miguelitoVargas/seqExplora/modulo_botones/pcb_mod_btn.kicad_pcb

## KiCad design modulo_botones/pcb_mod_btn.kicad_pcb (2018-06-20)

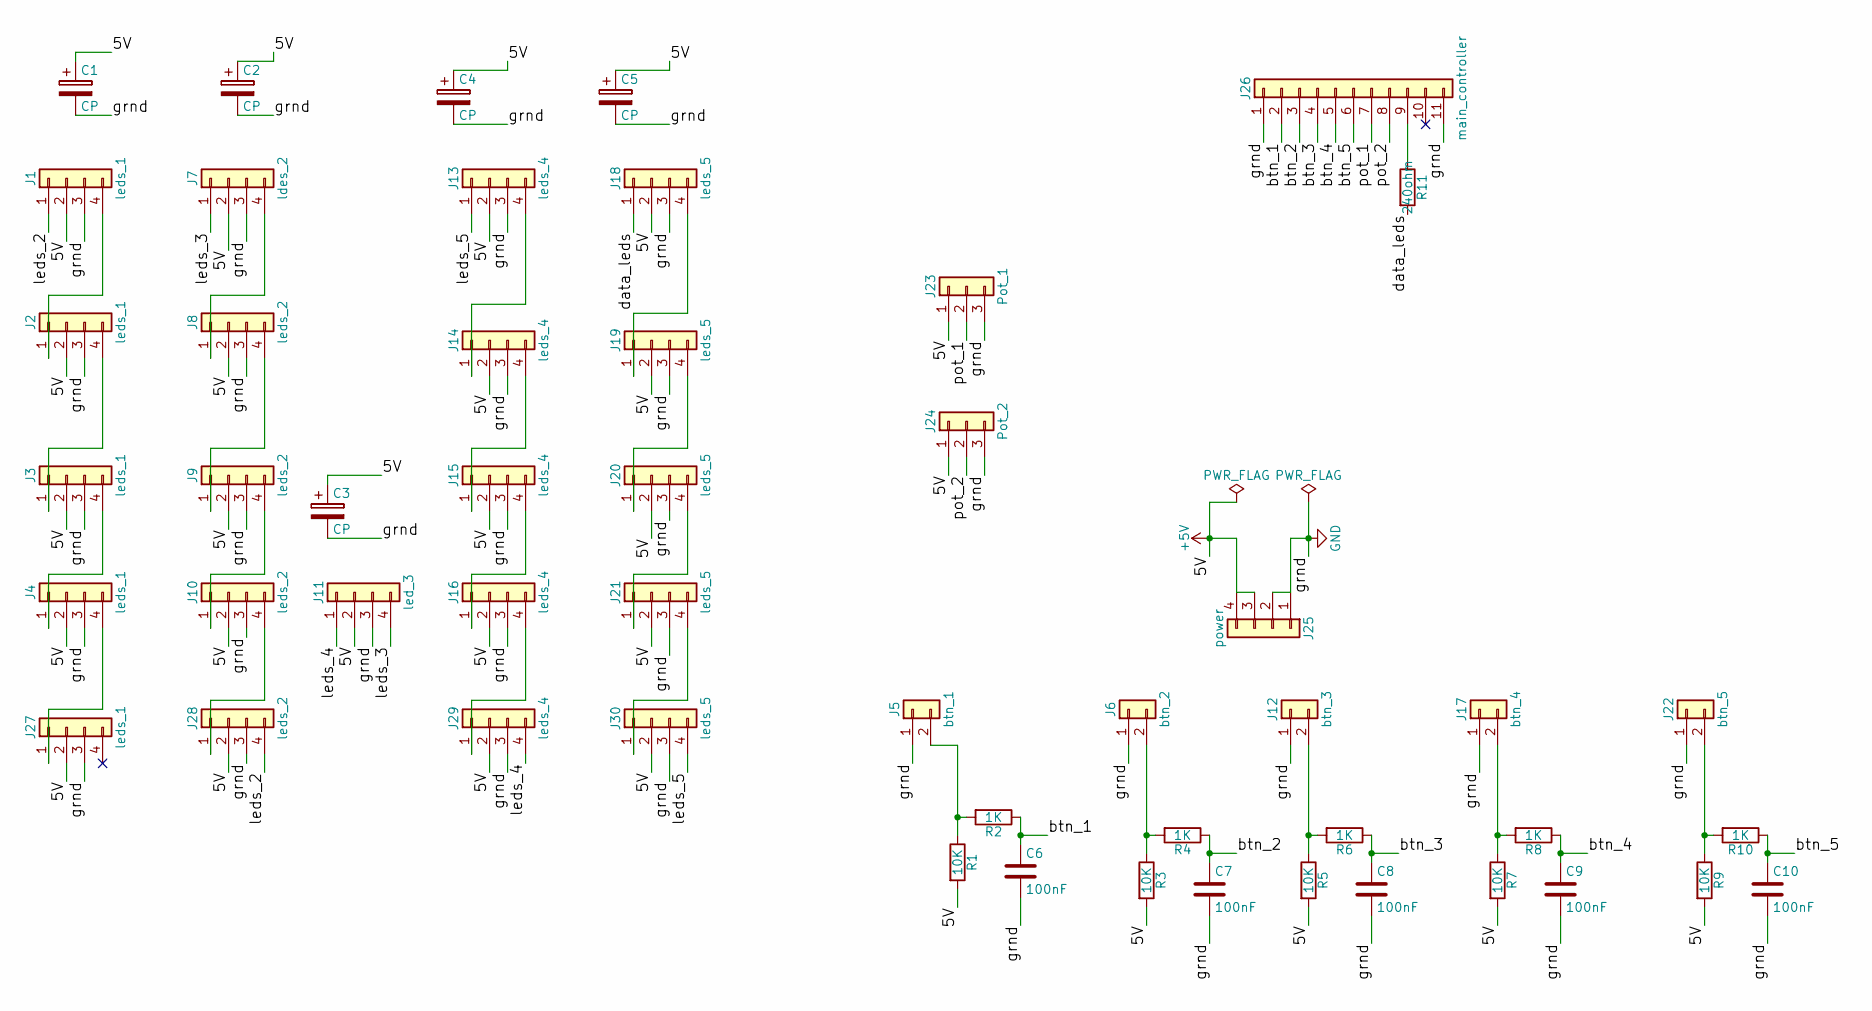
[picture p1: schematic pcb_mod_btn.sch]

Parts:
C1, C2, C3, C4, C5: CP; CP_Radial_D8.0mm_P5.00mm
C6, C7, C8, C9, C10: 100nF; C_0805_HandSoldering
J1, J2, J3, J4, J27: leds_1; Pin_Header_Straight_1x04_Pitch2.54mm
J5: btn_1; Pin_Header_Straight_1x02_Pitch2.54mm
J6: btn_2; Pin_Header_Straight_1x02_Pitch2.54mm
J7: ldes_2; Pin_Header_Straight_1x04_Pitch2.54mm
J8, J9, J10, J28: leds_2; Pin_Header_Straight_1x04_Pitch2.54mm
J11: led_3; Pin_Header_Straight_1x04_Pitch2.54mm
J12: btn_3; Pin_Header_Straight_1x02_Pitch2.54mm
J13, J14, J15, J16, J29: leds_4; Pin_Header_Straight_1x04_Pitch2.54mm
J17: btn_4; Pin_Header_Straight_1x02_Pitch2.54mm
J18, J19, J20, J21, J30: leds_5; Pin_Header_Straight_1x04_Pitch2.54mm
J22: btn_5; Pin_Header_Straight_1x02_Pitch2.54mm
J23: Pot_1; Pin_Header_Straight_1x03_Pitch2.54mm
J24: Pot_2; Pin_Header_Straight_1x03_Pitch2.54mm
J25: power; TerminalBlock_bornier-4_P5.08mm
J26: main_controller; Pin_Header_Straight_1x11_Pitch2.54mm
R1, R3, R5, R7, R9: 10K; R_0805_HandSoldering
R2, R4, R6, R8, R10: 1K; R_0805_HandSoldering
R11: 240ohm; R_0805_HandSoldering

Connections:
+5V: C1.1, C2.1, C3.1, C4.1, C5.1, J1.2, J2.2, J3.2, J4.2, J7.2, J8.2, J9.2, J10.2, J11.2, J13.2, J14.2, J15.2, J16.2, J18.2, J19.2, J20.2, J21.2, J23.1, J24.1, J25.3, J25.4, J27.2, J28.2, J29.2, J30.2, R1.2, R3.2, R5.2, R7.2, R9.2
/btn_1: C6.1, J26.2, R2.1
/btn_2: C7.1, J26.3, R4.1
/btn_3: C8.1, J26.4, R6.1
/btn_4: C9.1, J26.5, R8.1
/btn_5: C10.1, J26.6, R10.1
/data_leds: J18.1, R11.2
/leds_2: J1.1, J28.4
/leds_3: J7.1, J11.4
/leds_4: J11.1, J29.4
/leds_5: J13.1, J30.4
/pot_1: J23.2, J26.7
/pot_2: J24.2, J26.8
GND: C1.2, C2.2, C3.2, C4.2, C5.2, C6.2, C7.2, C8.2, C9.2, C10.2, J1.3, J2.3, J3.3, J4.3, J5.1, J6.1, J7.3, J8.3, J9.3, J10.3, J11.3, J12.1, J13.3, J14.3, J15.3, J16.3, J17.1, J18.3, J19.3, J20.3, J21.3, J22.1, J23.3, J24.3, J25.1, J25.2, J26.1, J26.11, J27.3, J28.3, J29.3, J30.3
unnamed: J1.4, J2.1
unnamed: J2.4, J3.1
unnamed: J3.4, J4.1
unnamed: J5.2, R1.1, R2.2
unnamed: J6.2, R3.1, R4.2
unnamed: J7.4, J8.1
unnamed: J8.4, J9.1
unnamed: J9.4, J10.1
unnamed: J10.4, J28.1
unnamed: J12.2, R5.1, R6.2
unnamed: J13.4, J14.1
unnamed: J14.4, J15.1
unnamed: J15.4, J16.1
unnamed: J16.4, J29.1
unnamed: J17.2, R7.1, R8.2
unnamed: J18.4, J19.1
unnamed: J19.4, J20.1
unnamed: J20.4, J21.1
unnamed: J21.4, J30.1
unnamed: J22.2, R9.1, R10.2
unnamed: J26.9, R11.1
unnamed: J4.4, J27.1

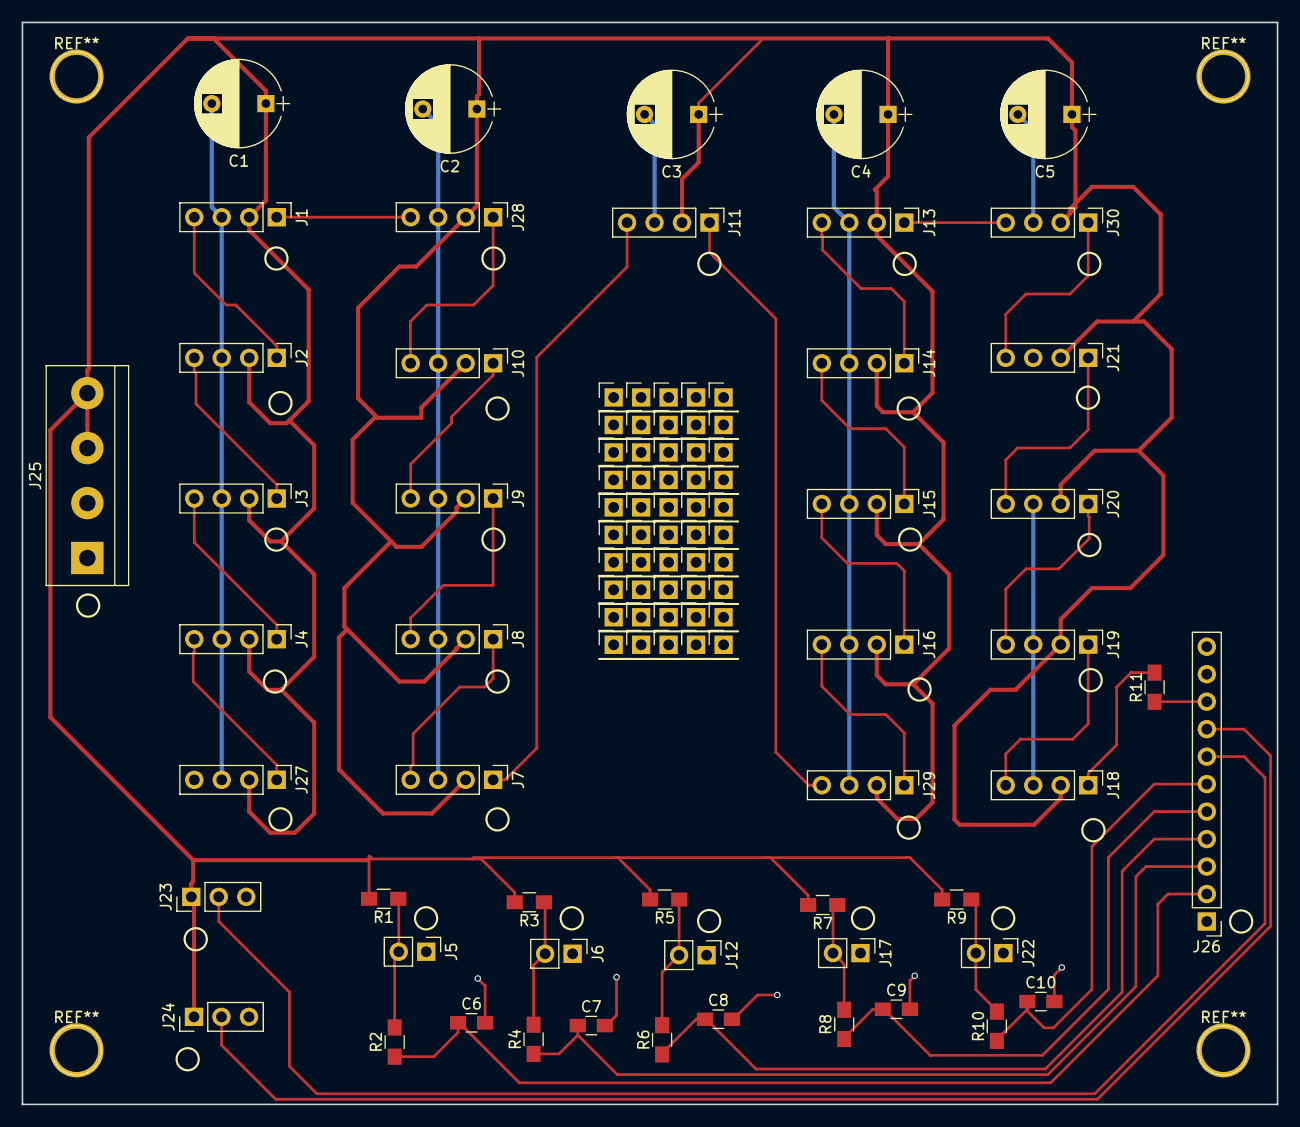
[picture p2: board pcb_mod_btn.kicad_pcb from above]

Board: 2 copper layers, 116.0 x 100.0 mm, 51 parts (0 on the bottom side), 36 nets.
