miguelitoVargas/seqExplora/modulo_arduino/pcb_mod_arduino.kicad_pcb

## KiCad design modulo_arduino/pcb_mod_arduino.kicad_pcb (2018-06-20)

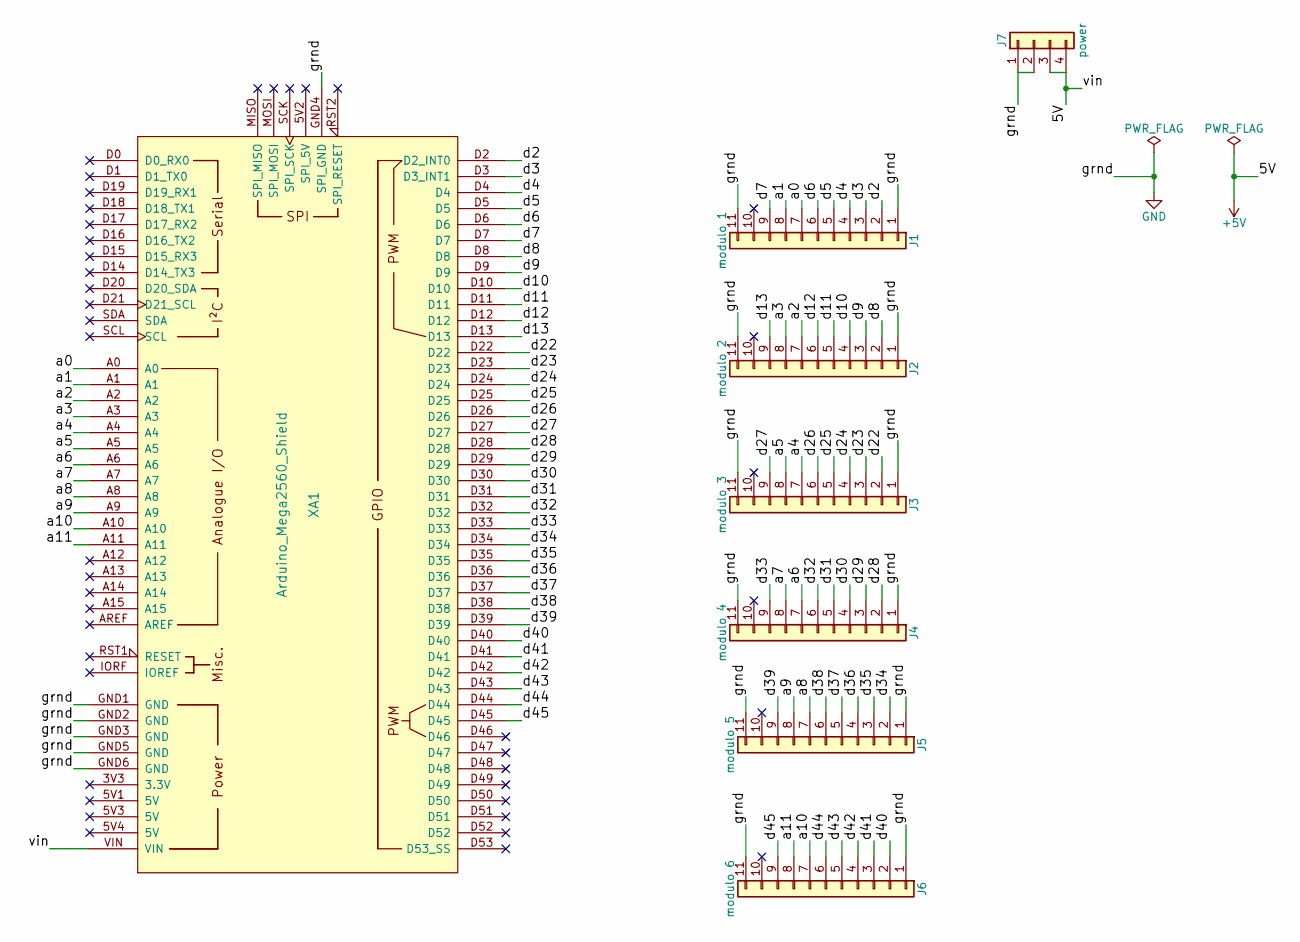
[picture p3: schematic pcb_mod_arduino.sch]

Parts:
J1: modulo 1; Pin_Header_Straight_1x11_Pitch2.54mm
J2: modulo 2; Pin_Header_Straight_1x11_Pitch2.54mm
J3: modulo 3; Pin_Header_Straight_1x11_Pitch2.54mm
J4: modulo 4; Pin_Header_Straight_1x11_Pitch2.54mm
J5: modulo 5; Pin_Header_Straight_1x11_Pitch2.54mm
J6: modulo 6; Pin_Header_Straight_1x11_Pitch2.54mm
J7: power; TerminalBlock_bornier-4_P5.08mm
XA1: Arduino_Mega2560_Shield

Connections:
+5V: J7.3, J7.4, XA1.VIN
/a0: J1.7, XA1.A0
/a1: J1.8, XA1.A1
/a2: J2.7, XA1.A2
/a3: J2.8, XA1.A3
/a4: J3.7, XA1.A4
/a5: J3.8, XA1.A5
/a6: J4.7, XA1.A6
/a7: J4.8, XA1.A7
/a8: J5.7, XA1.A8
/a9: J5.8, XA1.A9
/a10: J6.7, XA1.A10
/a11: J6.8, XA1.A11
/d2: J1.2, XA1.D2 (D2_INT0)
/d3: J1.3, XA1.D3 (D3_INT1)
/d4: J1.4, XA1.D4
/d5: J1.5, XA1.D5
/d6: J1.6, XA1.D6
/d7: J1.9, XA1.D7
/d8: J2.2, XA1.D8
/d9: J2.3, XA1.D9
/d10: J2.4, XA1.D10
/d11: J2.5, XA1.D11
/d12: J2.6, XA1.D12
/d13: J2.9, XA1.D13
/d22: J3.2, XA1.D22
/d23: J3.3, XA1.D23
/d24: J3.4, XA1.D24
/d25: J3.5, XA1.D25
/d26: J3.6, XA1.D26
/d27: J3.9, XA1.D27
/d28: J4.2, XA1.D28
/d29: J4.3, XA1.D29
/d30: J4.4, XA1.D30
/d31: J4.5, XA1.D31
/d32: J4.6, XA1.D32
/d33: J4.9, XA1.D33
/d34: J5.2, XA1.D34
/d35: J5.3, XA1.D35
/d36: J5.4, XA1.D36
/d37: J5.5, XA1.D37
/d38: J5.6, XA1.D38
/d39: J5.9, XA1.D39
/d40: J6.2, XA1.D40
/d41: J6.3, XA1.D41
/d42: J6.4, XA1.D42
/d43: J6.5, XA1.D43
/d44: J6.6, XA1.D44
/d45: J6.9, XA1.D45
GND: J1.1, J1.11, J2.1, J2.11, J3.1, J3.11, J4.1, J4.11, J5.1, J5.11, J6.1, J6.11, J7.1, J7.2, XA1.GND1 (GND), XA1.GND2 (GND), XA1.GND3 (GND), XA1.GND4 (SPI_GND), XA1.GND5 (GND), XA1.GND6 (GND)

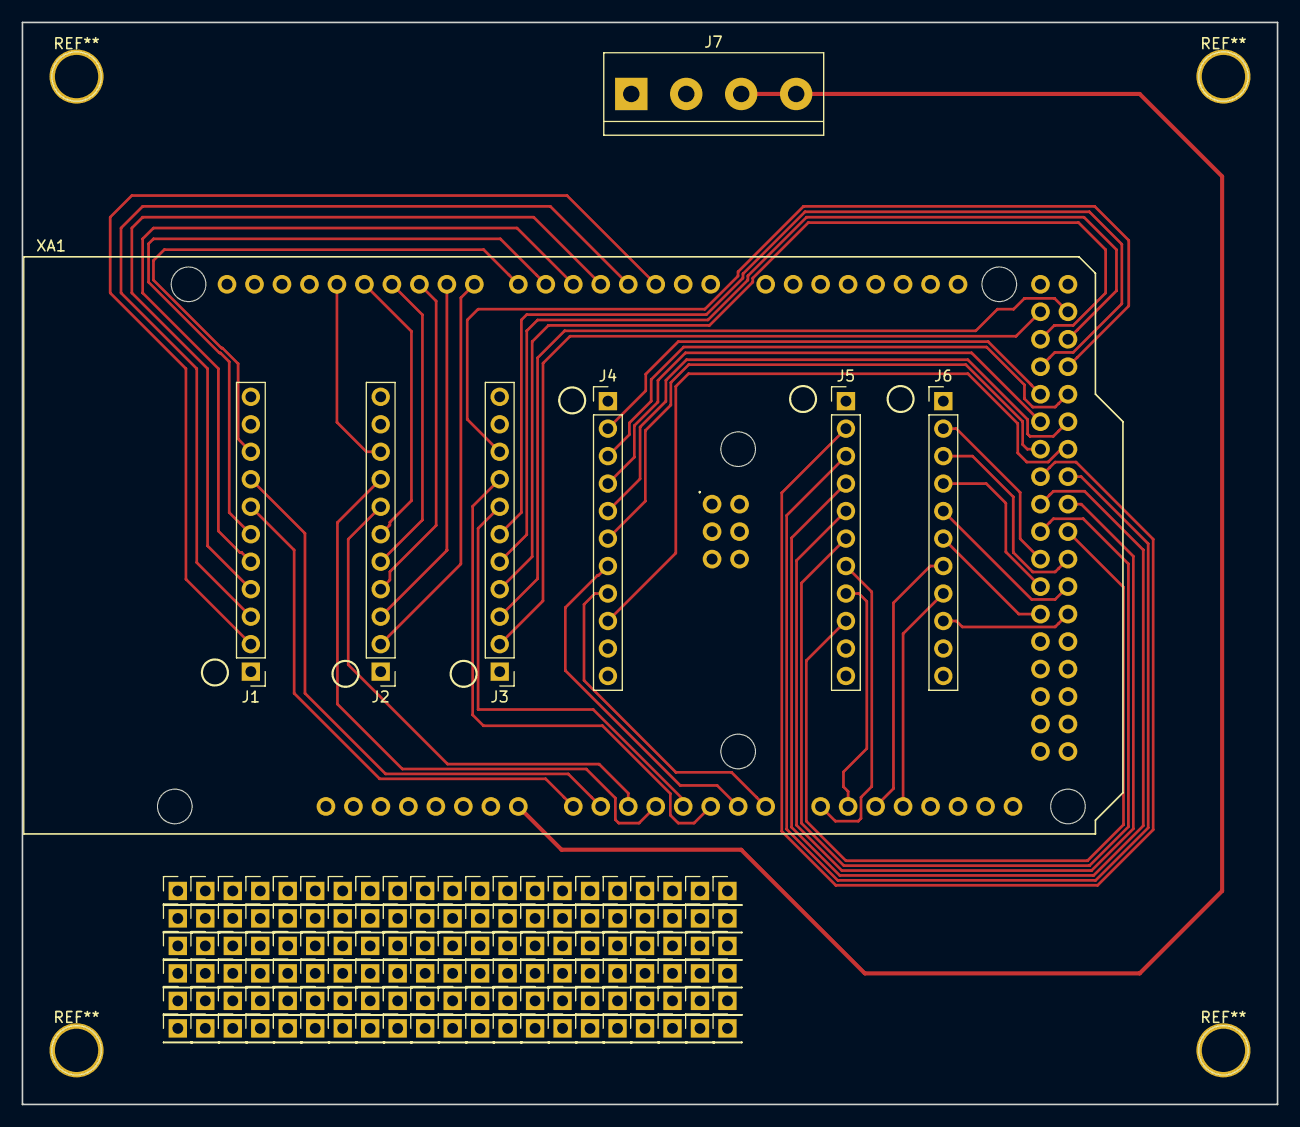
[picture p4: board pcb_mod_arduino.kicad_pcb from above]

Board: 2 copper layers, 116.0 x 100.0 mm, 8 parts (0 on the bottom side), 50 nets.
