miguelitoVargas/seqExplora/(threads)

Thread 4 (2018-06-15):

Tipo de condensadores

rvega, 2018-06-15:
Los capacitores C1, C2, C3, C4 y C5 deben ser condensadores electrolíticos (los que parecen un tanque de petroleo), de 8V o mas y de 1000uF o mas. No creo que con estas características encontremos uno en ese empaquetado tan pequeño que estás usando. Cambiar el footprint pa que quepan.

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

Closed 2018-06-17.

Thread 5 (2018-06-15):

Layout.

rvega, 2018-06-15:
Vamos a tener un montón de cables ribbon llegando a los headers de esta tarjeta. Por esto, mejor tener mas espacio entre un header y otro. Tanto vertical como horizontalmente. Me gusta la disposición en filas y columnas que tenés pero mientras menos apeñuscado, mejor.

miguelitoVargas, 2018-06-17:
quedaron mas separados, revisa, yo creo que asi esta bien pero creo que se pueden separar mas

rvega, 2018-06-18:
#8

Closed 2018-06-18.

Thread 6 (2018-06-15):

Poner marca que indique pin 1 de todos los headers

rvega, 2018-06-15:
Es muy fácil que con este tipo de conector se hagan conexiones en sentido equivocado. Poner una marca (un circulo o algo) en todos los headers que indique cual es el pin 1.  Sé que ahi está esa esquinita que indica cual es el pin 1 pero porfa poné algo mas visible.

miguelitoVargas, 2018-06-17:
hay marcas en las capas de silk del footprint, y es el pad con forma cuadrada si queres agrego igual marca al lado

rvega, 2018-06-18:
Si, en la capa silk veo ese cuadradito. Poné porfa algo mas visible en esa misma capa.  He visto que funciona bien poner un punto. Algo asi:

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

miguelitoVargas, 2018-06-18:
es un circulo sin relleno, revisa que este bien

rvega, 2018-06-20:
Falta poner la marca en los conectores de 1x2 de los botónes.

Thread 7 (2018-06-15):

Espacio de "protoboard"

rvega, 2018-06-15:
Acordate de poner un espacio con una cuadricula de pads para poder poner algunos componentes adicionales en la PCB, por si las moscas.

rvega, 2018-06-15:
El espacio entre pads debe ser el mismo que en un protoboard, creo que es 2.54mm pero no tengo como verificar en este momento.

rvega, 2018-06-15:
Si, es 2.54mm.

https://en.wikipedia.org/wiki/Pin_header

miguelitoVargas, 2018-06-17:
hay de varios pero si standard es 2.54mm

rvega, 2018-06-18:
Veo que ya lo pusiste en los 2 PCBs, cerrando.

Closed 2018-06-18.

Thread 11 (2018-06-18):

Posición del arduino mega en la tarjeta modulo_arduino.

rvega, 2018-06-18:
El borde izquierdo del PCB del Arudino Mega debe estar al ras con el borde izquierdo del PCB modulo_arduino. La razón es: El arduino vá a quedar en sanduche entre el panel de control (lámina metalica) y el modulo_arduino, entonces necesitamos que los conectores USB y Power del arduino queden visibles (saliendo).

miguelitoVargas, 2018-06-18:
ya quedo, revisalo para ver si se mueve mas

Closed 2018-06-20.

Thread 12 (2018-06-18):

Error en Kicad al abrir modulo_arduino

rvega, 2018-06-18:
Sale este mensaje de error:

```
The following libraries were not found:
/home/tc/ides_frameworks/kicad/footprints/arduino-kicad-library/arduino
```
El esquemático y el PCB parecen estar completos y bien. Hay alguna opción en Kicad de "guardar con todas las dependencias" o algo asi?

miguelitoVargas, 2018-06-18:
es esta libreria para arduino
https://github.com/Alarm-Siren/arduino-kicad-library
estan todas o casi las pcbs de arduino, hacer un submodulo o que instales la libreria en el tuyo

rvega, 2018-06-20:
Arreglado. Hacé pull.

Closed 2018-06-20.

Thread 13 (2018-06-18):

Conectar VIN del arduino a la entrada de 5V en modulo_arduino.

rvega, 2018-06-18:
El arduino mega se puede alimentar por el pin VIN. Conectar este pin al pin de +5V de la bornera power. Asi nos ahorramos el conector de power del arduino.

Closed 2018-06-18.

Thread 14 (2018-06-18):

Tamaño de la bornera "power" en ambos PCB.

rvega, 2018-06-18:
La bornera en ambos PCB está del mismo tamaño que los headers, esa bornera es mejor que sea mas grande, del tamaño de la verdesita que te entregué. Ponelas de ese tamaño, porfa.

Closed 2018-06-18.

Thread 8 (2018-06-18):

Espacio entre headers de leds en tarjeta modulo_botones.

rvega, 2018-06-18:
Los headers de 5x1 donde se conectan los leds pueden estar mas separadosen la dirección Y.  Porfa separarlos lo mas que se pueda para que al conectar los ribbons sea mas sencillo.

rvega, 2018-06-18:
Lo mismo los headers de 3x1 que se usan para los pots, un poco mas de espacio.

miguelitoVargas, 2018-06-18:
creo que ya no se podrian separar mas, revisa y comenta

Closed 2018-06-20.

Thread 9 (2018-06-18):

Orientación headers leds en modulo_botones.

rvega, 2018-06-18:
Relacionado con #8.

El pin número 1 de los headers de 5x1 donde se conectan los leds debería ir siempre hacia la izquierda o siempre hacia la derecha, para evitar errores a la hora de conectar. En este momento están intercalados. Uno hacia la iz, uno hacia la der, etc.

rvega, 2018-06-18:
Para que estén todas orientadas al mismo lado, las rutas de +5V pueden estar por el lado verde. Asi no te toca intercalar.

Closed 2018-06-18.
