miguelitoVargas/seqExplora/(commit log)

2018-06-15 esquematico primeras opciones de ruteo
    [pcb_mod_btn.kicad_pcb, pcb_mod_btn.sch]
2018-06-16 footprints para tornillos, modulo botones terminado, todo marcas pin 1 headers
    [pcb_mod_btn.kicad_pcb, pcb_mod_btn.sch]
2018-06-17 pcb arduino ok, revisar pitch pines independientes
    [pcb_mod_arduino.kicad_pcb, pcb_mod_arduino.sch, pcb_mod_btn.kicad_pcb, pcb_mod_btn.sch]
2018-06-18 marcas en pin #1 de headers, primer gerber export :3
    [pcb_mod_arduino.kicad_pcb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]
2018-06-18 marcas pines, reemplazo borneras, orientacion, separacion headers, ubicacion arduino
    [pcb_mod_arduino.kicad_pcb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]
2018-06-20 marcas botones ok, gerber exports ultima version
    [pcb_mod_arduino-B.Cu.gbr, pcb_mod_arduino-B.Fab.gbr, pcb_mod_arduino-B.SilkS.gbr, pcb_mod_arduino-Edge.Cuts.gbr, pcb_mod_arduino-F.Cu.gbr, pcb_mod_arduino-F.Fab.gbr, pcb_mod_arduino-F.SilkS.gbr, pcb_mod_arduino-NPTH.drl]
